ralfsgr/KiCAD_TMCM_1260_alternative/ETH_TMC_shield/ETH_TMC_shield.step

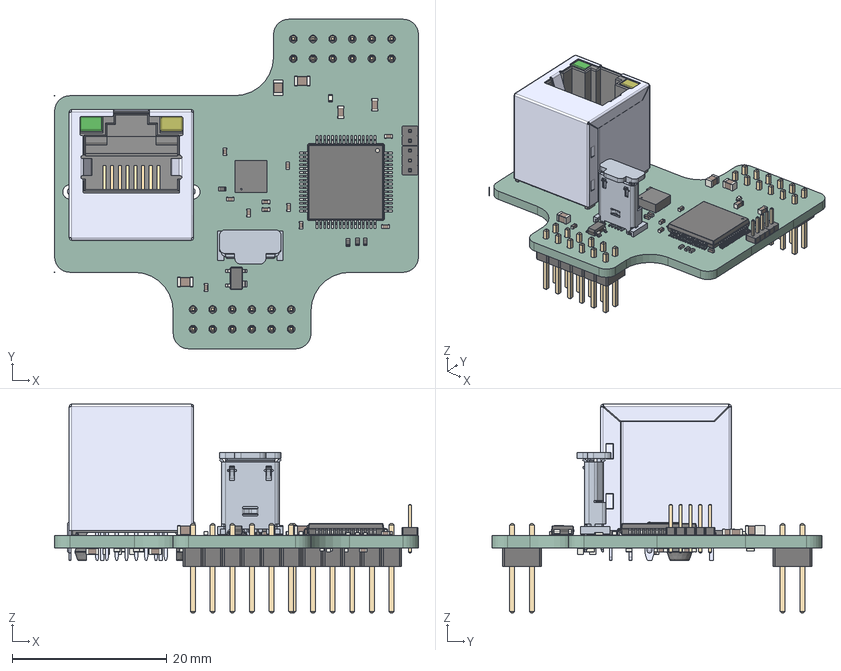
[picture p1: CAD file, 2026-02-16]
ETH_TMC_shield/ETH_TMC_shield.step
47.1 x 42.7 x 27.0 mm
LQFP_64_10x10mm_P05mm
C_0603_1608Metric x 7
R_0402_1005Metric x 6
C_0402_1005Metric x 15
C_0805_2012Metric x 3
JXD2-0Z10NL
SOT_143
PinHeader_2x06_P254mm_Vertical x 2
PinHeader_1x02_P127mm_Vertical
PinHeader_1x03_P127mm_Vertical
LED_0402_1005Metric
R_0603_1608Metric x 6
ETH_TMC_shield_PCB_1
ETH_TMC_shield_PCB_2
ETH_TMC_shield_PCB_3
