ralfsgr/KiCAD_TMCM_1260_alternative/TMCM_1260_alternative_ver_2/TMCM_1260_alternative_ver_2.step

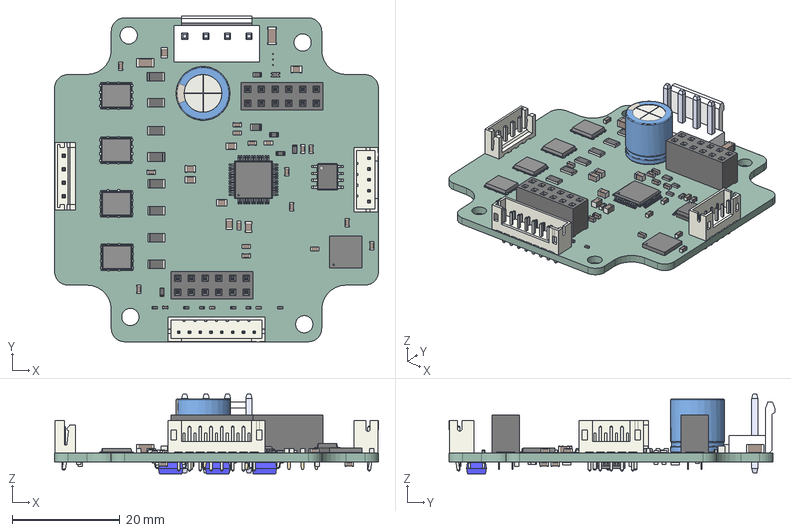
[picture p2: CAD file, 2026-02-16]
TMCM_1260_alternative_ver_2/TMCM_1260_alternative_ver_2.step
60.0 x 60.3 x 14.8 mm
C_0805_2012Metric x 8
C_0603_1608Metric x 23
R_0402_1005Metric x 6
C_0402_1005Metric x 3
R_1206_3216Metric x 10
NVMFD5852NLT1G x 4
C_1206_3216Metric x 2
B4P-VH
JST_B8B_PH_K
SOIC_8_39x49mm_P127mm
JST_B4B_EH_A
R_0603_1608Metric x 10
JST_B5B_PH_K
D_0603
CP_Radial_D100mm_P500mm
PinSocket_2x06_P254mm_Vertical x 2
R_0805_2012Metric
4pin SO6 x 3
TMCM_1260_alternative_ver_2_PCB
