ralfsgr/KiCAD_TMCM_1260_alternative/ETH_TMC_shield/Sketch1.dxf

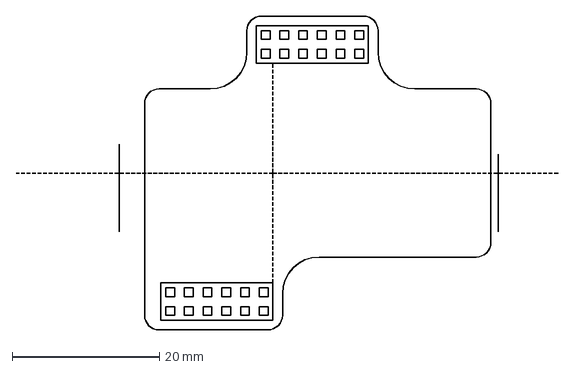
[picture p3: CAD file, 2026-02-10]
ETH_TMC_shield/Sketch1.dxf
73.7 x 42.7 mm
