ralfsgr/KiCAD_TMCM_1260_alternative/ETH_TMC_shield/TMCM-1260_user_drawing.dxf

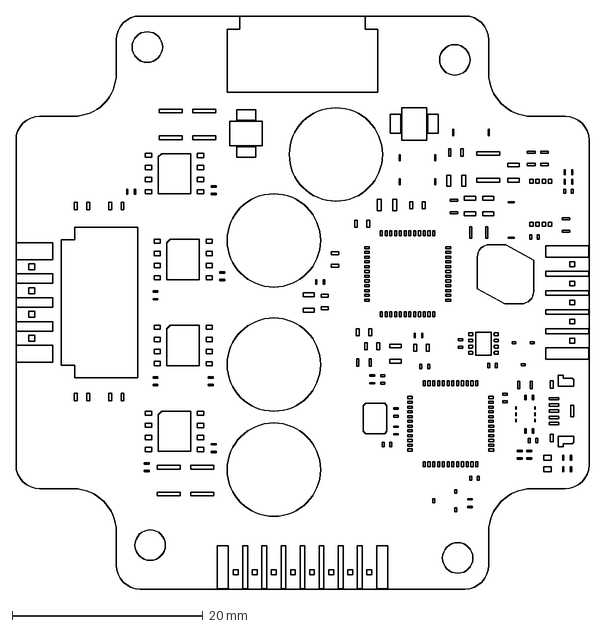
[picture p4: CAD file, 2025-12-11]
ETH_TMC_shield/TMCM-1260_user_drawing.dxf
60.0 x 60.0 mm
