ralfsgr/KiCAD_TMCM_1260_alternative/TMCM_1260_alternative_ver_2/TMCM_1260_alternative_ver_2.kicad_pcb

## KiCad design TMCM_1260_alternative_ver_2/TMCM_1260_alternative_ver_2.kicad_pcb (2026-03-10)

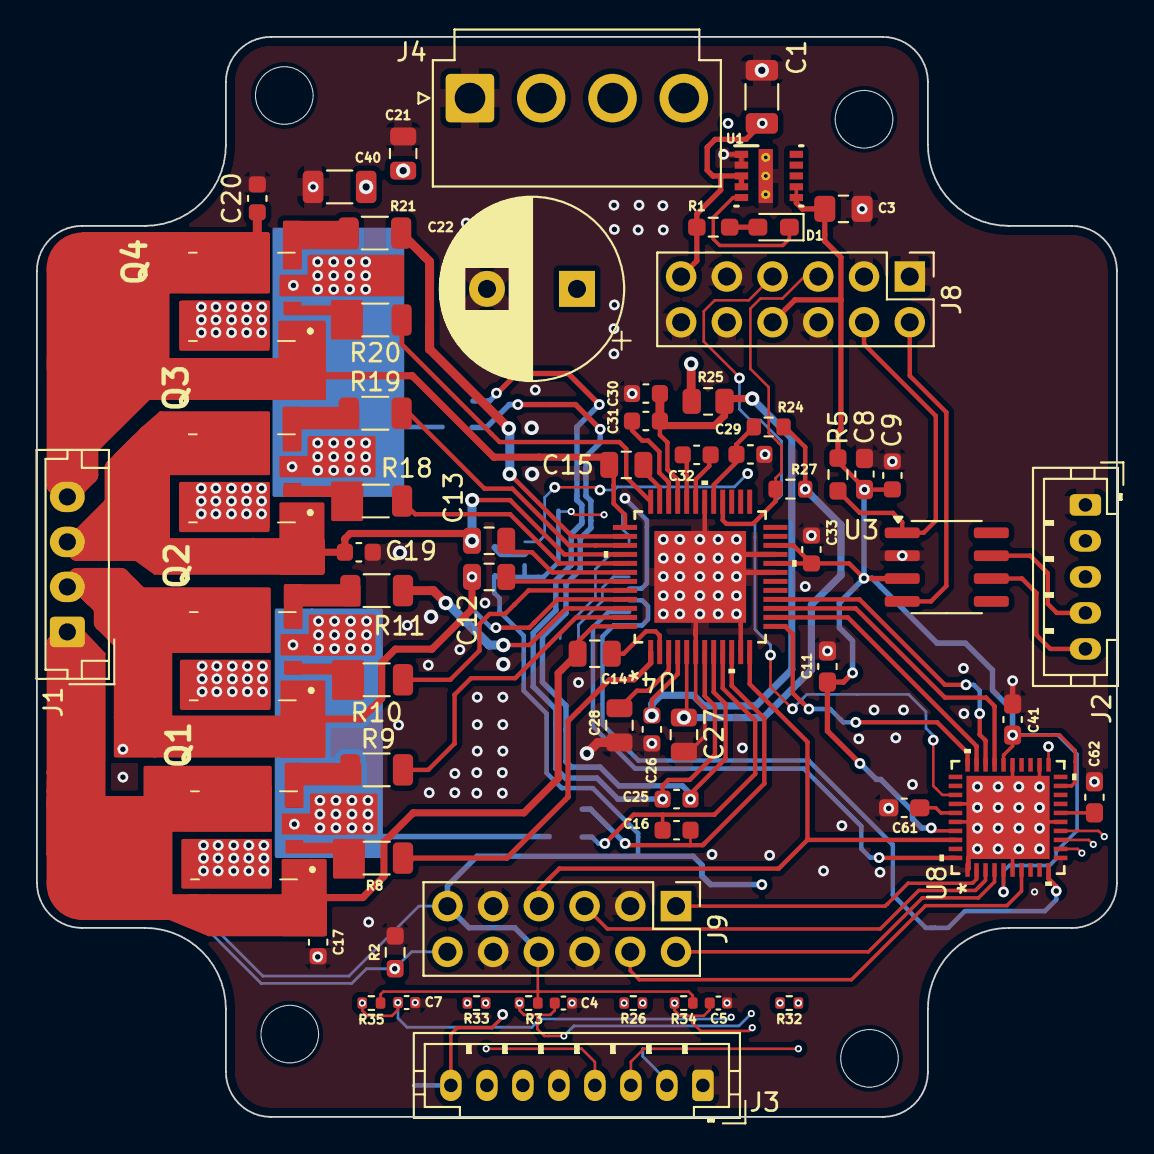
[picture p5: board TMCM_1260_alternative_ver_2.kicad_pcb from above]

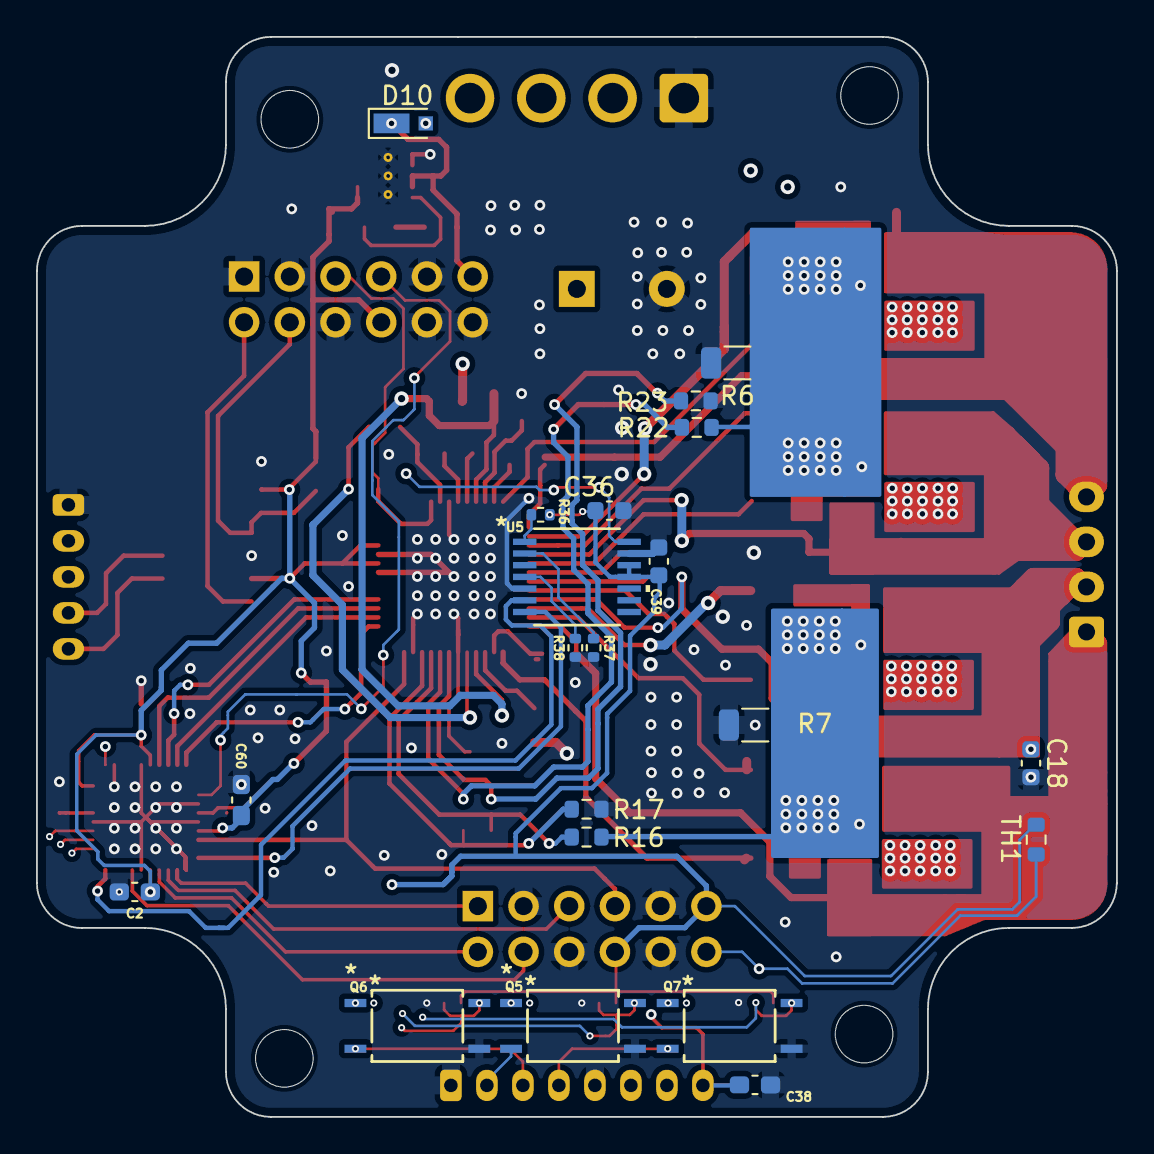
[picture p6: board TMCM_1260_alternative_ver_2.kicad_pcb from below]

Board: 4 copper layers, 60.0 x 60.0 mm, 87 parts (21 on the bottom side), 76 nets.

Parts:
C1: 10uF; C_1206_3216Metric
C2, C8, C11, C38, C41, C60, C61, C62: 0.1u; C_0603_1608Metric_Pad1.08x0.95mm_HandSolder
C3: 33uF; C_0805_2012Metric_Pad1.18x1.45mm_HandSolder
C4, C5, C7: 0.1u; C_0402_1005Metric
C9, C39: 1u; C_0603_1608Metric
C12, C13, C14, C15: 470nF; C_0805_2012Metric
C16, C25: 2n2; C_0603_1608Metric
C17, C18, C19, C20: 1n, 100V; C_0603_1608Metric
C21: 4u7; C_0805_2012Metric
C22: 330u; CP_Radial_D10.0mm_P5.00mm
C26, C36: 100n; C_0603_1608Metric
C27, C28: 10u; C_0805_2012Metric
C29, C30, C33: 470n; C_0603_1608Metric
C31: 100n, 16V; C_0603_1608Metric
C32: 22n, 100V; C_0603_1608Metric
C40: 47u; C_1206_3216Metric
D1: LED_RED; D_0603_1608Metric_Pad1.05x0.95mm_HandSolder
D10: D_Schottky; D_MicroSMP_AK
J1: Motor; JST_EH_B4B-EH-A_1x04_P2.50mm_Vertical
J2: CAN; JST_PH_B5B-PH-K_1x05_P2.00mm_Vertical
J3: I/O; JST_PH_B8B-PH-K_1x08_P2.00mm_Vertical
J4: Power; JST_VH_B4P-VH_1x04_P3.96mm_Vertical
J8, J9: Conn_02x06_Odd_Even; PinHeader_2x06_P2.54mm_Vertical
Q1, Q2, Q3, Q4: NVMFD5C650NLT1G; NVMFD5C446NLWFT1G
Q5, Q6, Q7: TLP185GR-TPL_SE; TLP185_GR_TPL_SE
R1: 2k; R_0603_1608Metric_Pad0.98x0.95mm_HandSolder
R2: 10k; R_0603_1608Metric_Pad0.98x0.95mm_HandSolder
R3, R34, R35, R36, R37, R38: 4k7; R_0402_1005Metric
R5: 4k7; R_0603_1608Metric_Pad0.98x0.95mm_HandSolder
R6, R7: 0.075; R_1206_3216Metric
R8, R9, R10, R11, R18, R19, R20, R21: 15; R_1206_3216Metric
R16, R17, R22, R23: 47; R_0603_1608Metric
R24: 2R2; R_0603_1608Metric
R25: 1R; R_0805_2012Metric
R26, R32, R33: 24k; R_0402_1005Metric
R27: 4k7; R_0603_1608Metric
TH1: Thermistor_NTC; R_0603_1608Metric
U1: LMZM23600V3SILR
U3: TCAN337; SOIC-8_3.9x4.9mm_P1.27mm
U4: TMC5160A-TA-T; TMC5160A_TA_T
U5: AS5047P-ATSM; AS5047P_ATSM
U8: TMC4361A-LA-T; TMC4361A_LA_T

Connections:
5VOUT: C27.1, C38.1, J3.8, R24.1, R27.1, U4.5 (5VOUT)
12-36V: C21.1, C22.1, C40.1, D10.2 (A), J3.6, J3.7, J4.2, J4.3, Q1.7 (D1_1), Q1.8 (D1_2), Q1.9 (D1_3), Q1.10 (D1_4), Q1.14, Q2.7 (D1_1), Q2.8 (D1_2), Q2.9 (D1_3), Q2.10 (D1_4), Q2.14, Q3.7 (D1_1), Q3.8 (D1_2), Q3.9 (D1_3), Q3.10 (D1_4), Q3.14, Q4.7 (D1_1), Q4.8 (D1_2), Q4.9 (D1_3), Q4.10 (D1_4), Q4.14, R25.1, R26.2, R32.2, R33.2
/CANH: J2.4, U3.7 (CANH)
/CANL: J2.5, U3.6 (CANL)
/RXD: J8.2, U3.4 (RXD)
/TXD: J8.4, R5.1, U3.1 (TXD)
BMA1: C13.2, C19.1, J1.3, Q3.1 (S1), Q3.5 (D2_1), Q3.6 (D2_2), Q3.11 (D2_3), Q3.12 (D2_4), Q3.13, U4.40 (BMA1)
BMA2: C15.2, C20.1, J1.4, Q4.1 (S1), Q4.5 (D2_1), Q4.6 (D2_2), Q4.11 (D2_3), Q4.12 (D2_4), Q4.13, U4.37 (BMA2)
BMB1: C14.2, C17.1, J1.1, Q1.1 (S1), Q1.5 (D2_1), Q1.6 (D2_2), Q1.11 (D2_3), Q1.12 (D2_4), Q1.13, U4.48 (BMB1)
BMB2: C12.2, C18.1, J1.2, Q2.1 (S1), Q2.5 (D2_1), Q2.6 (D2_2), Q2.11 (D2_3), Q2.12 (D2_4), Q2.13, U4.45 (BMB2)
CA1: C13.1, U4.42 (CA1)
CA2: C15.1, U4.35 (CA2)
CB1: C14.1, U4.2 (CB1)
CB2: C12.1, U4.43 (CB2)
CLK_EXT: J9.7, U4.12 (CLK), U8.38 (CLK_EXT)
CPI: C32.1, U4.32 (CPI)
CPO: C32.2, U4.31 (CPO)
CSN: J9.1, U8.2 (NSCSIN)
CSN_DRV: U4.13 (CSN_CFG3), U8.30 (NSCSDRV_SDO)
DRV_ENN: J8.5, R27.2, U4.28 (DRV_ENN)
GND: C1.2, C2.2, C3.2, C4.2, C5.2, C7.2, C8.2, C9.2, C11.2, C17.2, C18.2, C19.2, C20.2, C21.2, C22.2, C26.2, C27.2, C28.2, C29.2, C30.1, C33.2, C36.1, C38.2, C39.1, C40.2, C41.1, C60.1, C61.1, C62.1, J2.1, J3.1, J3.5, J4.1, J8.1, J8.3, J8.6, J8.9, J8.10, J8.12, J9.3, J9.6, J9.9, J9.10, Q5.4, Q6.4, Q7.4, R2.1, R6.2, R7.2, R17.1, R23.1, R37.2, R38.2, U1.1 (GND), U1.2 (MODE_SYNC), U1.11 (PAD), U1.PAD, U3.2 (GND), U4.6 (GNDA), U4.11 (TST_MODE), U4.19 (GNDD), U4.21 (SD_MODE), U4.30 (GNDD), U4.49 (GNDD/GNDP), U5.5 (TEST), U5.13 (GND), U8.1 (ANEG_NSCLK), U8.6 (GND), U8.11 (BNEG_NSDI), U8.15 (GND), U8.22 (NNEG), U8.25 (GND), U8.34 (TEST_MODE), U8.36 (GND), U8.41
HA1: R18.1, U4.41 (HA1)
HA2: R20.1, U4.36 (HA2)
HB1: R8.1, U4.1 (HB1)
HB2: R10.1, U4.44 (HB2)
HOME_REF: C4.1, Q5.6, R3.1, U8.13 (HOME_REF)
INCR_A: U5.7 (A), U8.40 (A_SCLK)
INCR_B: U5.6 (B), U8.10 (B_SDI)
INCR_I: U5.14 (I/PWM), U8.21 (N)
INTR: J8.7, U8.33 (INTR)
LA1: R19.1, U4.39 (LA1)
LA2: R21.1, U4.38 (LA2)
LB1: R9.1, U4.47 (LB1)
LB2: R11.1, U4.46 (LB2)
unnamed: C61.2, U8.35 (VDD1V8)
unnamed: C62.2, U8.16 (VDD1V8)
unnamed: D1.2 (A), R1.1
unnamed: D1.1 (K), U1.5 (PGOOD)
unnamed: Q1.2 (G1), R8.2
unnamed: Q1.4 (G2), R9.2
unnamed: Q1.3 (S2), Q2.3 (S2), R7.1, R16.1
unnamed: Q2.2 (G1), R10.2
unnamed: Q2.4 (G2), R11.2
unnamed: Q3.2 (G1), R18.2
unnamed: Q3.4 (G2), R19.2
unnamed: Q3.3 (S2), Q4.3 (S2), R6.1, R22.1
unnamed: Q4.2 (G1), R20.2
unnamed: Q4.4 (G2), R21.2
unnamed: Q5.1, R26.1
unnamed: Q6.1, R32.1
unnamed: Q7.1, R33.1
unnamed: C28.1, U4.3 (12VOUT)
unnamed: C29.1, R24.2, U4.29 (VCC)
unnamed: R37.1, U5.2 (CLK)
unnamed: R36.1, U5.1 (CSn)
unnamed: R38.1, U5.4 (MOSI)
Out_1: J3.4, Q7.3
Out_2: J3.3, Q6.3
PGOOD: C1.1, D10.1 (K), J8.11, R1.2, U1.3 (VIN), U1.4 (EN)
SCK: J9.5, U8.3 (SCKIN)
SCK_DRV: U4.14 (SCK_CFG2), U8.29 (SCKDRV_NSDO)
SPI_MISO: J9.4, U8.7 (SDOIN)
SPI_MISO_DRV: U4.16 (SDO_CFG0), U8.28 (SDIDRV_NSCLK)
SPI_MOSI: J9.2, U8.4 (SDIIN)
SPI_MOSI_DRV: U4.15 (SDI_CFG1), U8.27 (SDODRV_SCLK)
SRAH: C25.1, R22.2, U4.8 (SRAH)
SRAL: C25.2, R23.2, U4.7 (SRAL)
SRBH: C16.1, R16.2, U4.9 (SRBH)
SRBL: C16.2, R17.2, U4.10 (SRBL)
STOPL: C7.1, Q7.6, R35.1, U8.12 (STOPL)
STOPR: C5.1, Q6.6, R34.1, U8.14 (STOPR)
VCC_IO: C2.1, C3.1, C8.1, C9.1, C11.1, C33.1, C36.2, C39.2, C41.2, C60.2, J8.8, J9.8, J9.11, R3.2, R5.2, R34.2, R35.2, R36.2, TH1.2, U1.6 (VOUT), U1.7 (FB), U3.3 (VCC), U4.20 (VCC_IO), U4.22 (SPI_MODE), U5.11 (VDD), U5.12 (VDD3V), U8.5 (VCC), U8.19 (NFREEZE), U8.26 (VCC), U8.37 (VCC)
VCP: C31.2, U4.34 (VCP)
VS: C26.1, C30.2, C31.1, R25.2, U4.4 (VSA), U4.33 (VS)
home: J3.2, Q5.3
monitoring: J9.12, R2.2, TH1.1
