ralfsgr/KiCAD_TMCM_1260_alternative/ETH_TMC_shield/ETH_TMC_shield.kicad_pcb

## KiCad design ETH_TMC_shield/ETH_TMC_shield.kicad_pcb (2026-02-17)

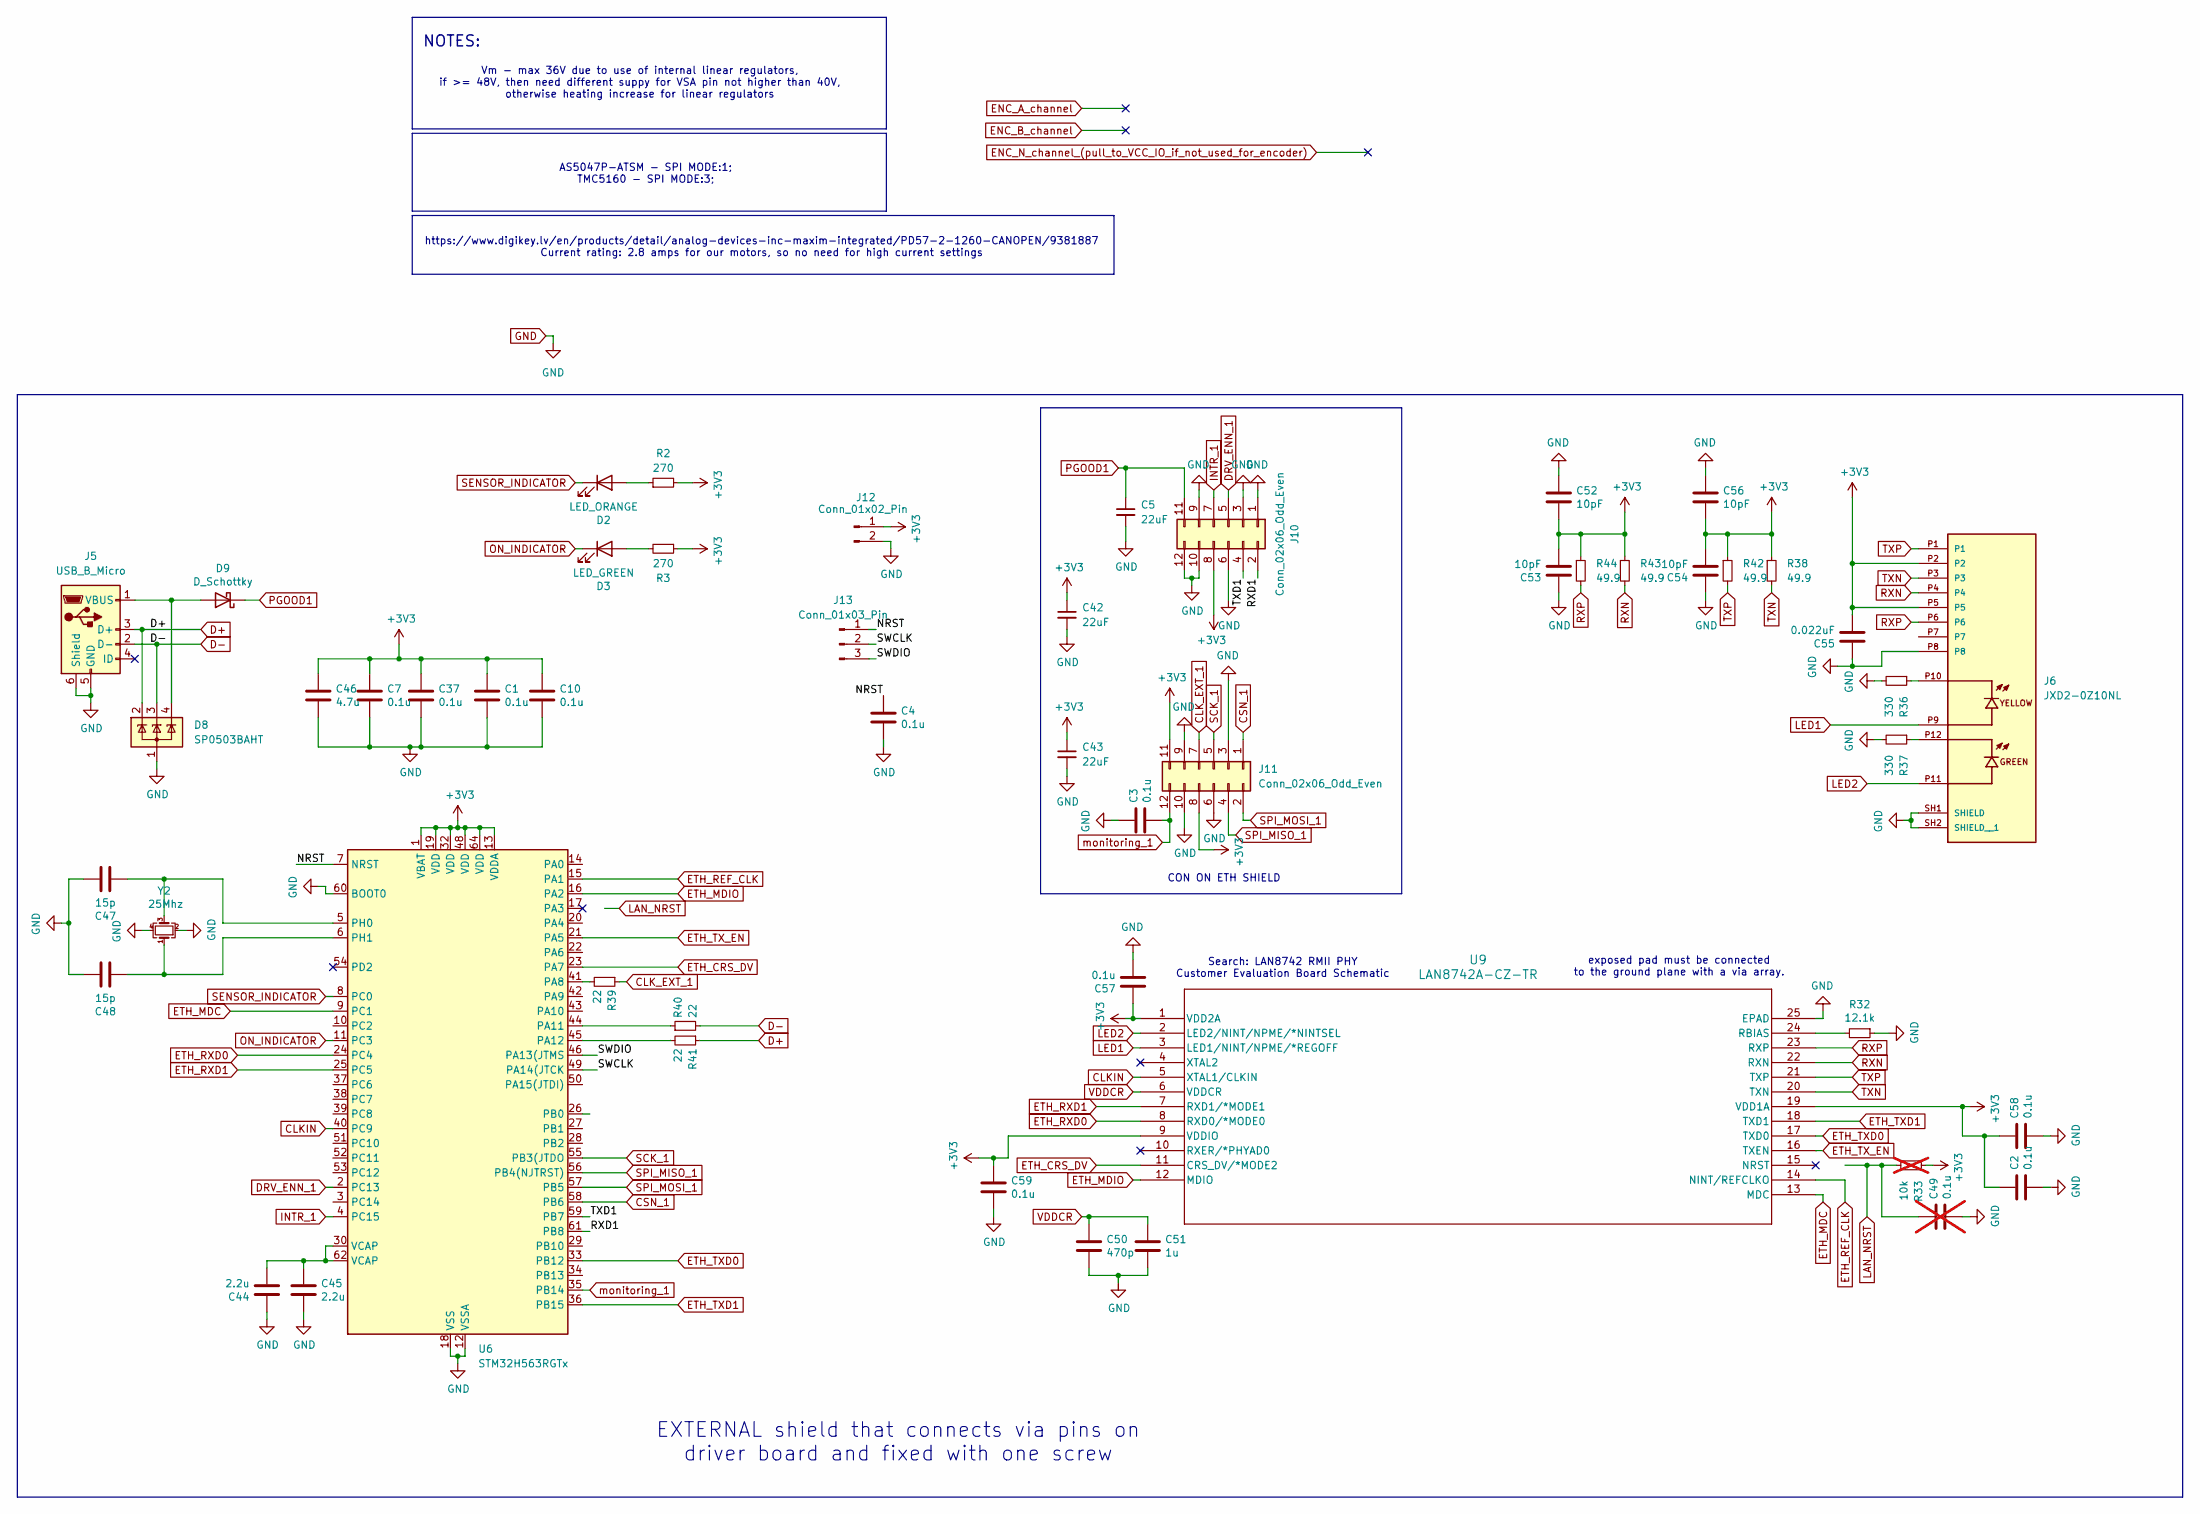
[picture p7: schematic ETH_TMC_shield.kicad_sch]

Parts:
C1, C2, C3, C4, C7, C10, C37, C57, C58, C59: 0.1u; C_0402_1005Metric
C5, C42, C43: 22uF; C_0805_2012Metric_Pad1.18x1.45mm_HandSolder
C44, C45: 2.2u; C_0402_1005Metric
C46: 4.7u; C_0402_1005Metric
C47, C48: 15p; C_0603_1608Metric
C49: 0.1u; C_0603_1608Metric_Pad1.08x0.95mm_HandSolder; not fitted
C50: 470p; C_0402_1005Metric
C51: 1u; C_0402_1005Metric
C52, C53, C54, C56: 10pF; C_0603_1608Metric_Pad1.08x0.95mm_HandSolder
C55: 0.022uF; C_0603_1608Metric_Pad1.08x0.95mm_HandSolder
D2: LED_ORANGE; LED_0402_1005Metric
D3: LED_GREEN; D_0402_1005Metric
D8: SP0503BAHT; SOT-143
D9: D_Schottky; D_MicroSMP_AK
J5: USB_B_Micro; USB_Micro-B_Molex-105133-0031
J6: JXD2-0Z10NL; JXD2_0Z10NL; PARTREV 08/23
J10, J11: Conn_02x06_Odd_Even; PinHeader_2x06_P2.54mm_Vertical
J12: Conn_01x02_Pin; PinHeader_1x02_P1.27mm_Vertical
J13: Conn_01x03_Pin; PinHeader_1x03_P1.27mm_Vertical
R2, R3: 270; R_0402_1005Metric
R32: 12.1k; R_0402_1005Metric
R33: 10k; R_0603_1608Metric; not fitted
R36, R37: 330; R_0603_1608Metric
R38, R42, R43, R44: 49.9; R_0603_1608Metric
R39, R40, R41: 22; R_0402_1005Metric
U6: STM32H563RGTx; LQFP-64_10x10mm_P0.5mm
U9: LAN8742A-CZ-TR; LAN8742A_CZ_TR
Y2: 25Mhz; Crystal_SMD_2016-4Pin_2.0x1.6mm

Connections:
+3V3: C1.1, C2.1, C7.1, C10.1, C37.1, C42.1, C43.1, C46.1, C52.2, C53.2, C54.2, C55.2, C56.2, C57.1, C58.1, C59.1, J6.P2, J6.P5, J10.8, J11.8, J11.11, J12.1, R2.2, R3.1, R33.1, R38.1, R42.1, R43.1, R44.1, U6.1 (VBAT), U6.13 (VDDA), U6.19 (VDD), U6.32 (VDD), U6.48 (VDD), U6.64 (VDD), U9.1 (VDD2A), U9.9 (VDDIO), U9.19 (VDD1A)
/NRST: C4.1, J13.1, U6.7 (NRST)
/RXD1: J10.2, U6.61 (PB8)
/SWCLK: J13.2, U6.49 (PA14(JTCK)
/SWDIO: J13.3, U6.46 (PA13(JTMS)
/TXD1: J10.4, U6.59 (PB7)
CLKIN: U6.40 (PC9), U9.5 (XTAL1/CLKIN)
CLK_EXT_1: J11.7, R39.1
CSN_1: J11.1, U6.58 (PB6)
D+: D8.2 (K), J5.3 (D+), R41.1
D-: D8.3 (K), J5.2 (D-), R40.2
DRV_ENN_1: J10.5, U6.2 (PC13)
ETH_CRS_DV: U6.23 (PA7), U9.11 (CRS_DV/*MODE2)
ETH_MDC: U6.9 (PC1), U9.13 (MDC)
ETH_MDIO: U6.16 (PA2), U9.12 (MDIO)
ETH_REF_CLK: U6.15 (PA1), U9.14 (NINT/REFCLKO)
ETH_RXD0: U6.24 (PC4), U9.8 (RXD0/*MODE0)
ETH_RXD1: U6.25 (PC5), U9.7 (RXD1/*MODE1)
ETH_TXD0: U6.33 (PB12), U9.17 (TXD0)
ETH_TXD1: U6.36 (PB15), U9.18 (TXD1)
ETH_TX_EN: U6.21 (PA5), U9.16 (TXEN)
GND: C1.2, C2.2, C3.1, C4.2, C5.2, C7.2, C10.2, C37.2, C42.2, C43.2, C44.1, C45.2, C46.2, C47.1, C48.1, C49.2, C50.2, C51.2, C52.1, C53.1, C54.1, C55.1, C56.1, C57.2, C58.2, C59.2, D8.1 (A), J5.5 (GND), J5.6 (Shield), J6.P8, J6.SH1 (SHIELD), J6.SH2 (SHIELD__1), J10.1, J10.3, J10.6, J10.9, J10.10, J10.12, J11.3, J11.6, J11.9, J11.10, J12.2, R32.1, R36.2, R37.2, U6.12 (VSSA), U6.18 (VSS), U6.31 (VSS), U6.47 (VSS), U6.60 (BOOT0), U6.63 (VSS), U9.25 (EPAD), Y2.2, Y2.4
INTR_1: J10.7, U6.4 (PC15)
LED1: J6.P9, U9.3 (LED1/NINT/NPME/*REGOFF)
LED2: J6.P11, U9.2 (LED2/NINT/NPME/*NINTSEL)
unnamed: C44.2, C45.1, U6.30 (VCAP), U6.62 (VCAP)
unnamed: C49.1, R33.2
unnamed: D2.2 (A), R2.1
unnamed: D3.2 (A), R3.2
unnamed: D8.4 (K), D9.2 (A), J5.1 (VBUS)
unnamed: J6.P10, R36.1
unnamed: J6.P12, R37.1
unnamed: R39.2, U6.41 (PA8)
unnamed: R40.1, U6.44 (PA11)
unnamed: R41.2, U6.45 (PA12)
unnamed: C47.2, U6.5 (PH0), Y2.3
unnamed: C48.2, U6.6 (PH1), Y2.1
unnamed: R32.2, U9.24 (RBIAS)
ON_INDICATOR: D3.1 (K), U6.11 (PC3)
PGOOD1: C5.1, D9.1 (K), J10.11
RXN: J6.P4, R43.2, U9.22 (RXN)
RXP: J6.P6, R44.2, U9.23 (RXP)
SCK_1: J11.5, U6.55 (PB3(JTDO)
SENSOR_INDICATOR: D2.1 (K), U6.8 (PC0)
SPI_MISO_1: J11.4, U6.56 (PB4(NJTRST))
SPI_MOSI_1: J11.2, U6.57 (PB5)
TXN: J6.P3, R38.2, U9.20 (TXN)
TXP: J6.P1, R42.2, U9.21 (TXP)
VDDCR: C50.1, C51.1, U9.6 (VDDCR)
monitoring_1: C3.2, J11.12, U6.35 (PB14)

Notes on the sheet:
AS5047P-ATSM - SPI MODE:1; TMC5160 - SPI MODE:3;
exposed pad must be connected to the ground plane with a via array.
CON ON ETH SHIELD
Search: LAN8742 RMII PHY Customer Evaluation Board Schematic
EXTERNAL shield that connects via pins on driver board and fixed with one screw
NOTES:
Vm - max 36V due to use of internal linear regulators, if >= 48V, then need different suppy for VSA pin not higher than 40V, otherwise heating increase for linear regulators
https://www.digikey.lv/en/products/detail/analog-devices-inc-maxim-integrated/PD57-2-1260-CANOPEN/9381887 Current rating: 2.8 amps for our motors, so no need for high current settings

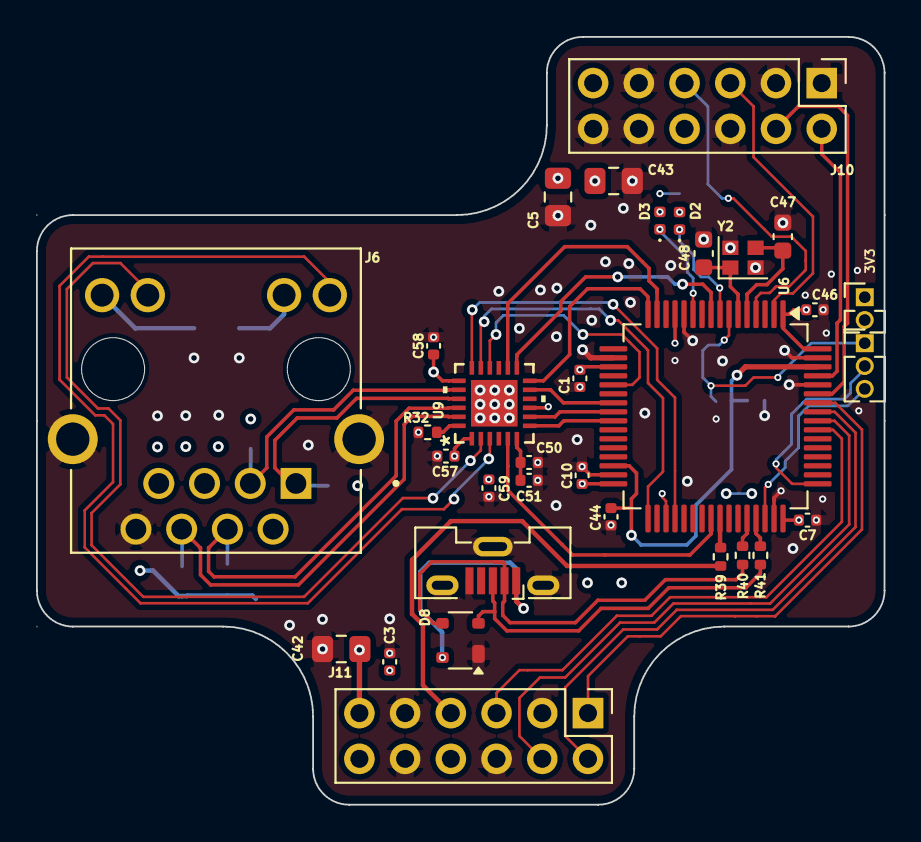
[picture p8: board ETH_TMC_shield.kicad_pcb from above]

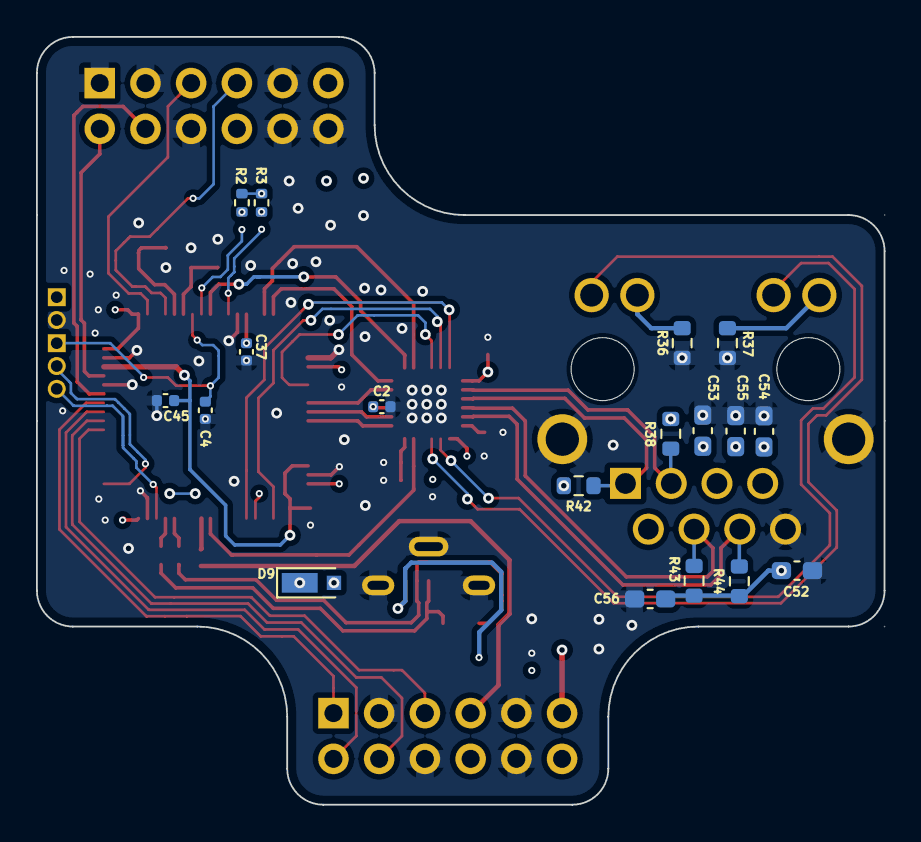
[picture p9: board ETH_TMC_shield.kicad_pcb from below]

Board: 4 copper layers, 47.1 x 42.7 mm, 50 parts (18 on the bottom side), 49 nets.
