ralfsgr/KiCAD_TMCM_1260_alternative/(commit log)

2025-12-11 not finished
    [TMCM-1260_edge_cut.dxf, TMCM-1260_user_drawing.dxf, TMCM_1260_alternative.kicad_pcb, TMCM_1260_alternative.kicad_sch]
2026-01-27 iterration 2 upload
    [TMCM-1260_edge_cut.dxf, TMCM-1260_user_drawing.dxf, TMCM_1260_alternative_ver_2.kicad_pcb, TMCM_1260_alternative_ver_2.kicad_sch]
2026-01-27 second version started
    [TMCM_1260_alternative_ver_2.kicad_pcb, TMCM_1260_alternative_ver_2.kicad_sch]
2026-02-04 tmc4361 added ver_2
    [TMCM_1260_alternative_ver_2.kicad_pcb, TMCM_1260_alternative_ver_2.kicad_sch]
2026-02-04 internal stm32 usb added
    [TMCM_1260_alternative_ver_2.kicad_sch]
2026-02-07 ver 2 design not finished
    [TMCM-1260_edge_cut.dxf, TMCM-1260_user_drawing.dxf, TMCM_1260_alternative_ver_2.kicad_pcb, TMCM_1260_alternative_ver_2.kicad_sch, TMCM_1260_alternative_ver_2_quilter.kicad_pcb, TMCM_1260_alternative_ver_2_quilter.kicad_sch]
2026-02-08 ver2 not finished
    [TMCM_1260_alternative_ver_2.kicad_pcb]
2026-02-10 not finish
    [Sketch1.dxf, TMCM_1260_alternative_ver_2.kicad_pcb, TMCM_1260_alternative_ver_2.kicad_sch]
2026-02-11 not ready
    [TMCM_1260_alternative_ver_2.kicad_pcb, TMCM_1260_alternative_ver_2.kicad_sch]
2026-02-12 finished not checked
    [ETH_TMC_shield.kicad_pcb, ETH_TMC_shield.kicad_sch, Sketch1.dxf, TMCM-1260_edge_cut.dxf, TMCM-1260_user_drawing.dxf, TMCM_1260_alternative_ver_2.kicad_pcb, TMCM_1260_alternative_ver_2.kicad_sch]
2026-02-17 absolute encoder SPI switched to ABI incremental
    [ETH_TMC_shield.kicad_pcb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]
